SteveintheIoW/T-Display-S3-JK-BMS-BLE-to-Solis-CAN-Pylontech/Photos_Media/All Cell Volts.jpg

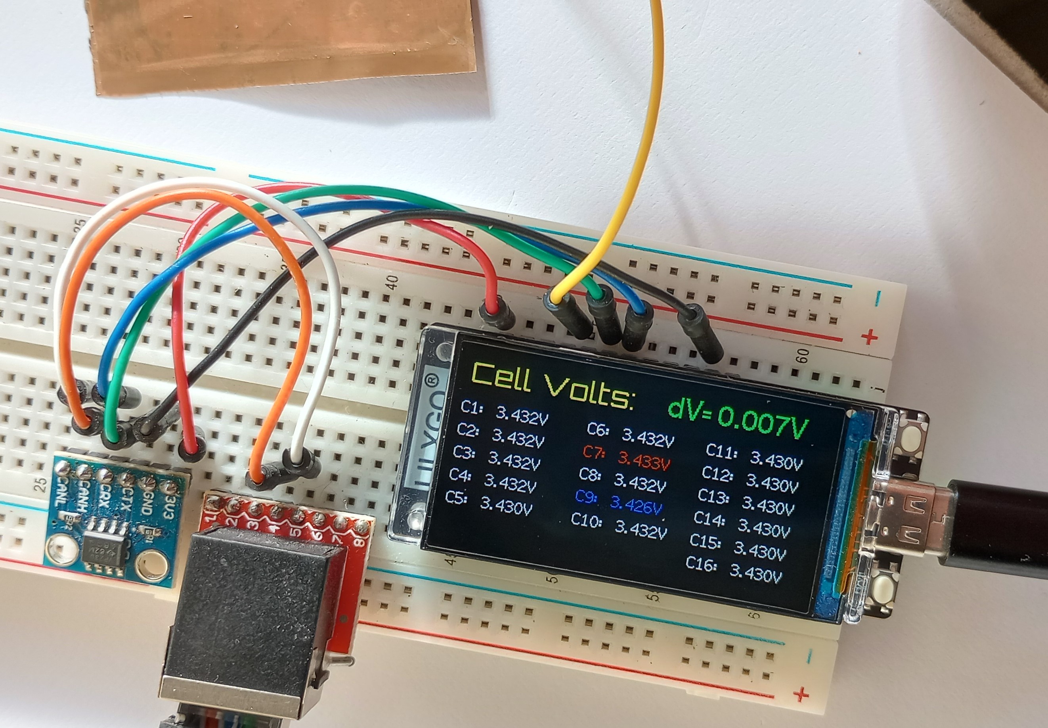
Photos_Media/All Cell Volts.jpg
