SteveintheIoW/T-Display-S3-JK-BMS-BLE-to-Solis-CAN-Pylontech/Photos_Media/CAN Screen.jpg

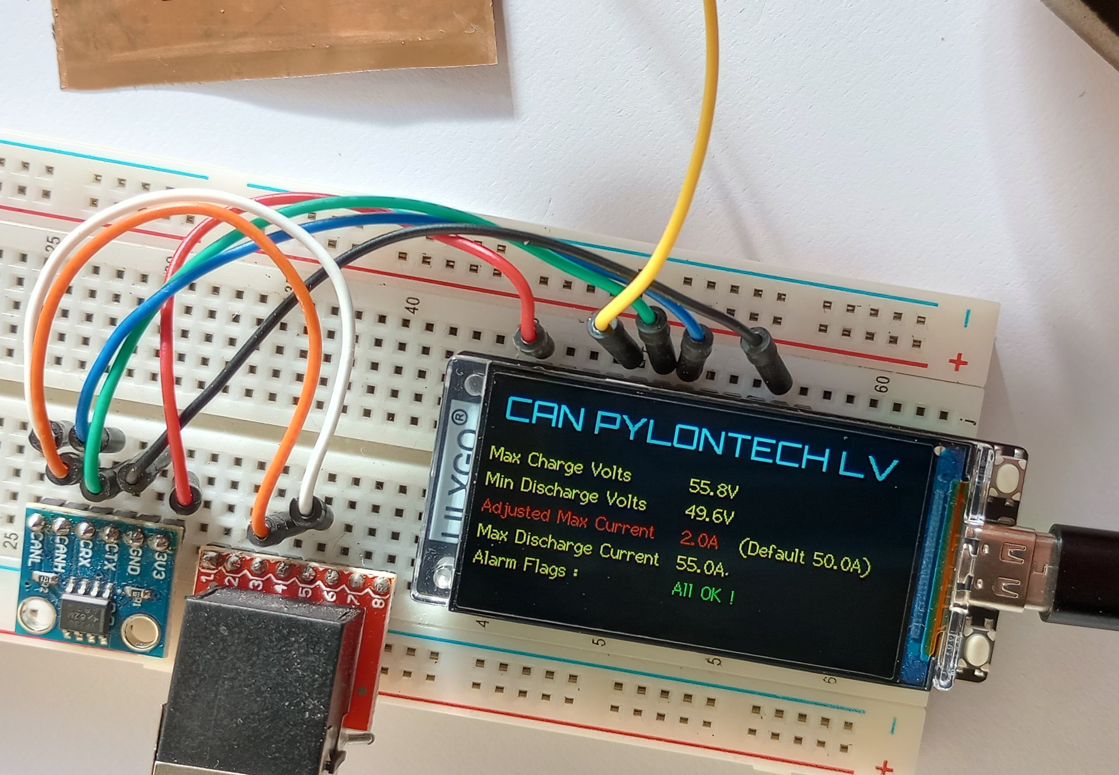
Photos_Media/CAN Screen.jpg
