SteveintheIoW/T-Display-S3-JK-BMS-BLE-to-Solis-CAN-Pylontech/Photos_Media/Copper plant label.jpg

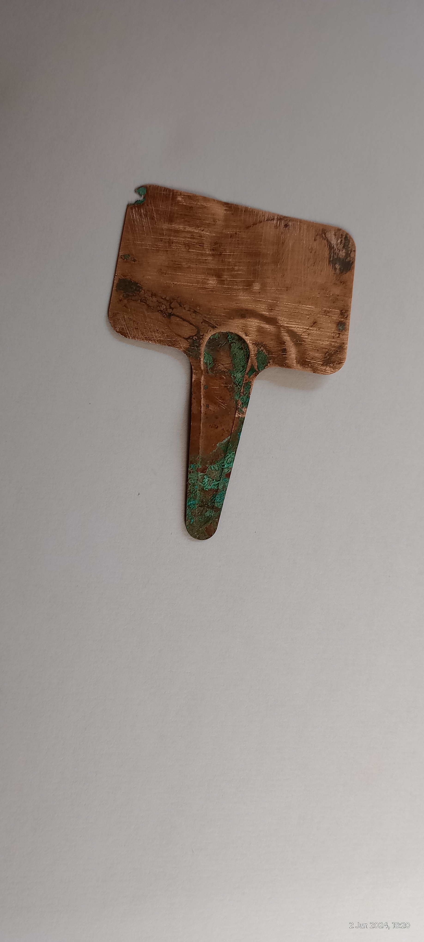
Photos_Media/Copper plant label.jpg
