SteveintheIoW/T-Display-S3-JK-BMS-BLE-to-Solis-CAN-Pylontech/Photos_Media/Found BMS.jpg

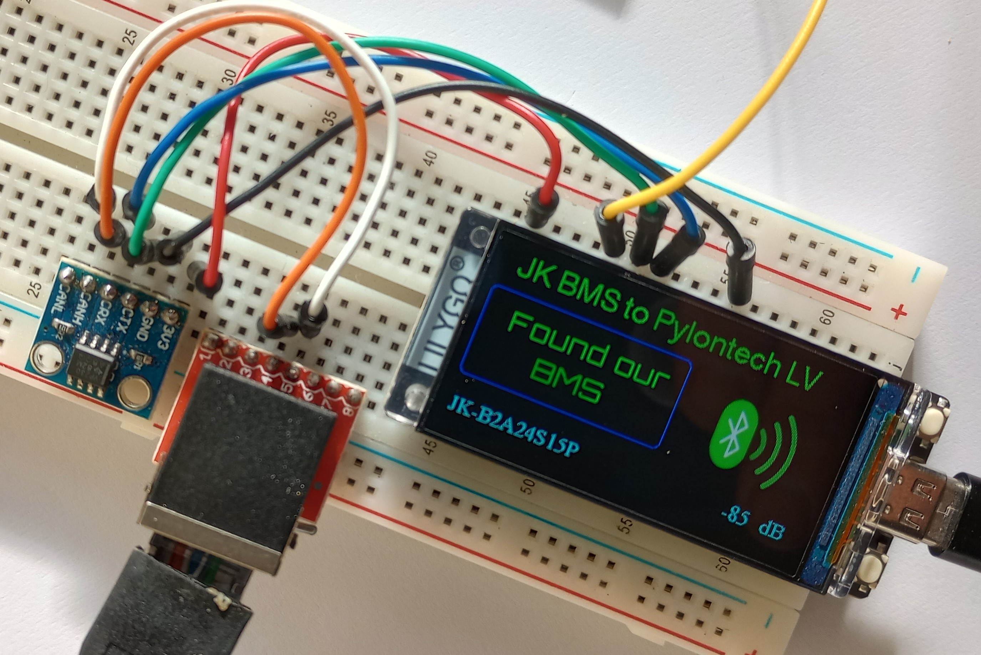
Photos_Media/Found BMS.jpg
