SteveintheIoW/T-Display-S3-JK-BMS-BLE-to-Solis-CAN-Pylontech/Photos_Media/IMG_20240602_184514970_HDR.jpg

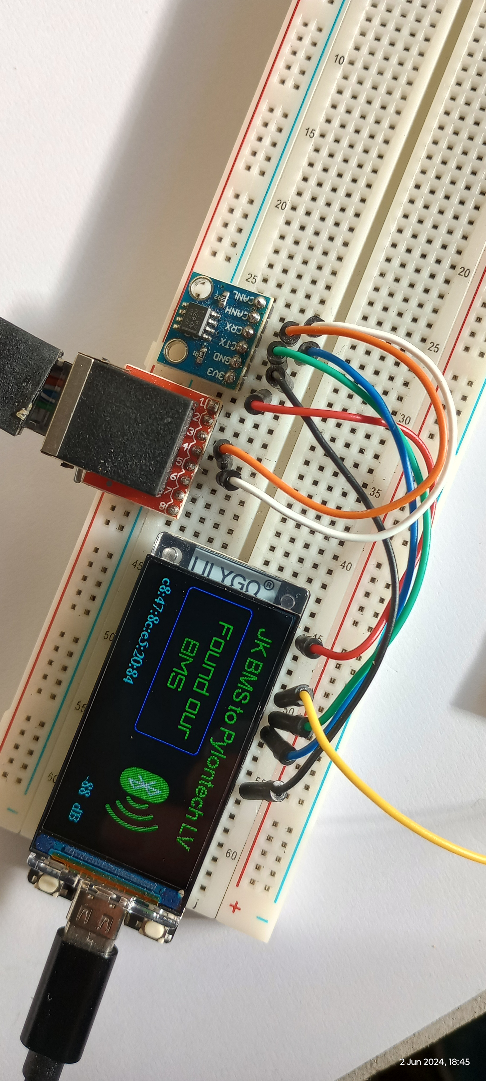
Photos_Media/IMG_20240602_184514970_HDR.jpg
