SteveintheIoW/T-Display-S3-JK-BMS-BLE-to-Solis-CAN-Pylontech/Photos_Media/Interface and Solis EH1 System.jpg

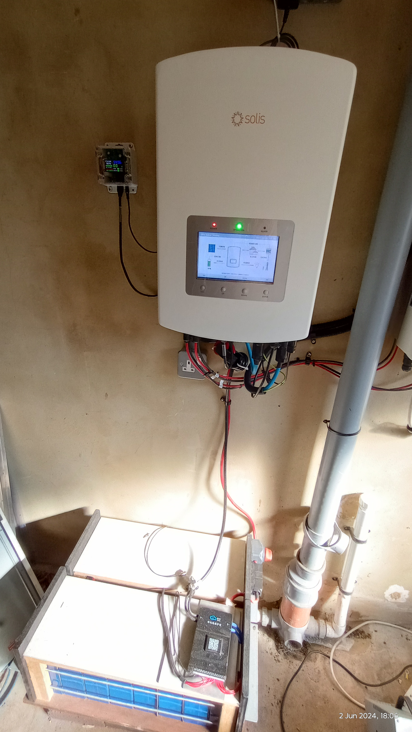
Photos_Media/Interface and Solis EH1 System.jpg
