SteveintheIoW/T-Display-S3-JK-BMS-BLE-to-Solis-CAN-Pylontech/Photos_Media/Multicomp Enclosure.jpg

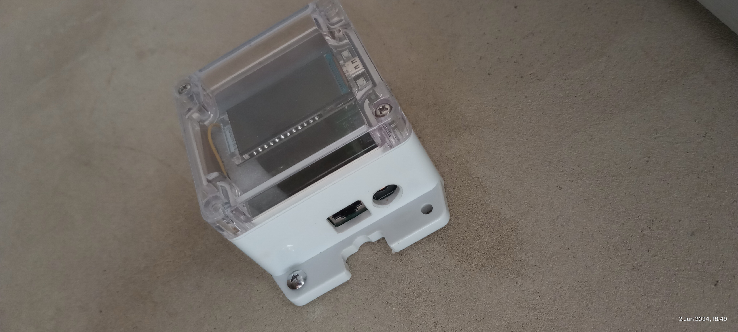
Photos_Media/Multicomp Enclosure.jpg
