SteveintheIoW/T-Display-S3-JK-BMS-BLE-to-Solis-CAN-Pylontech/Photos_Media/PCB in Enclosure.jpg

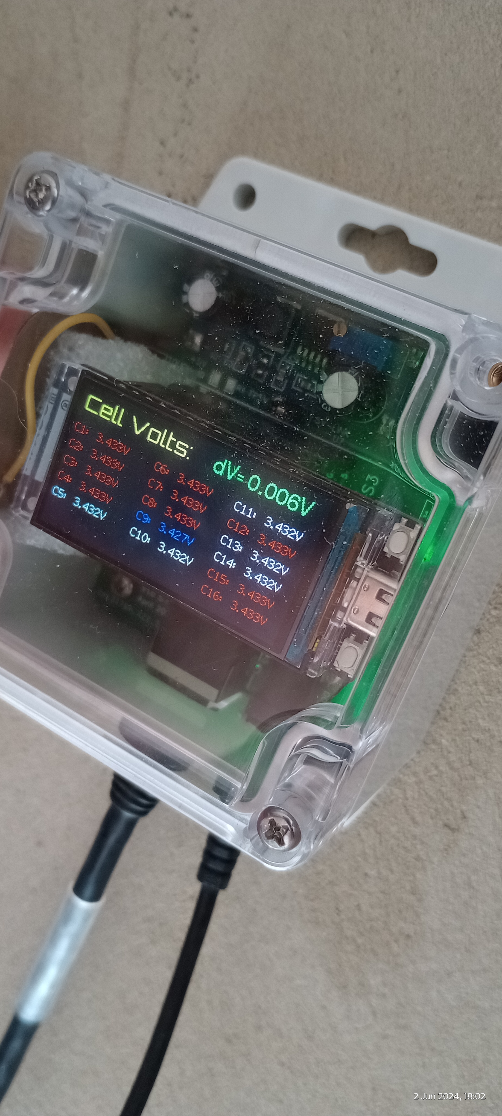
Photos_Media/PCB in Enclosure.jpg
