SteveintheIoW/T-Display-S3-JK-BMS-BLE-to-Solis-CAN-Pylontech/Photos_Media/PCB.jpg

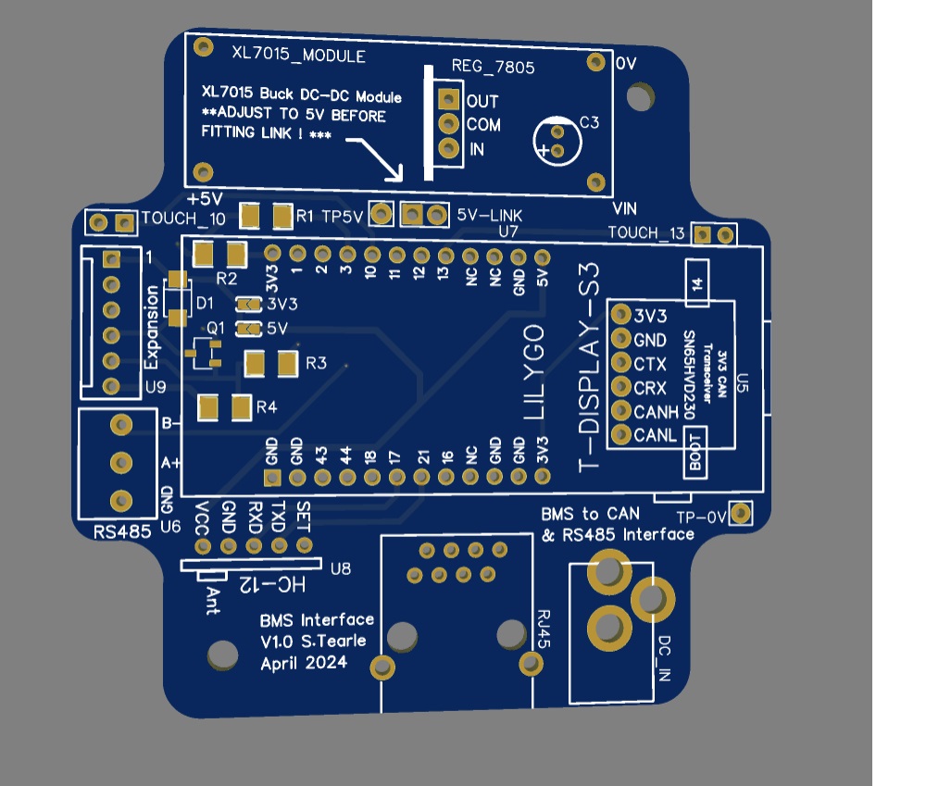
Photos_Media/PCB.jpg
