SteveintheIoW/T-Display-S3-JK-BMS-BLE-to-Solis-CAN-Pylontech/Photos_Media/Touch Pad.jpg

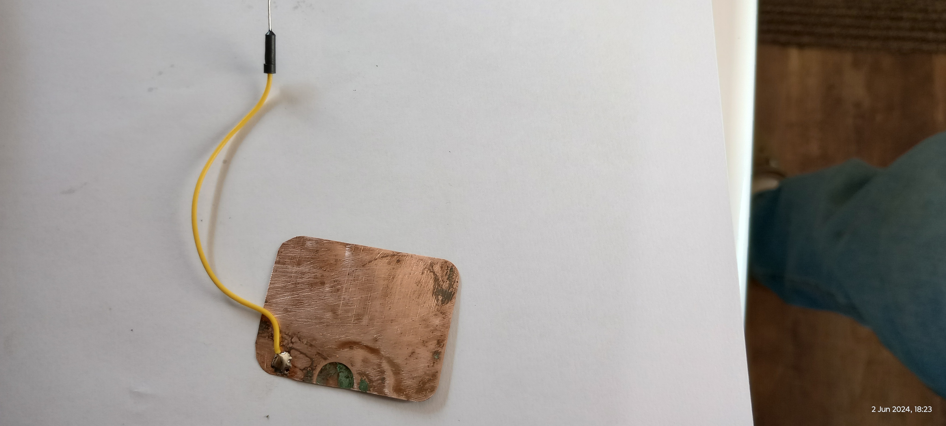
Photos_Media/Touch Pad.jpg
