SteveintheIoW/T-Display-S3-JK-BMS-BLE-to-Solis-CAN-Pylontech/Photos_Media/T-Display S3  JKBMS BLE to CAN Interface  - relevant parts.pdf

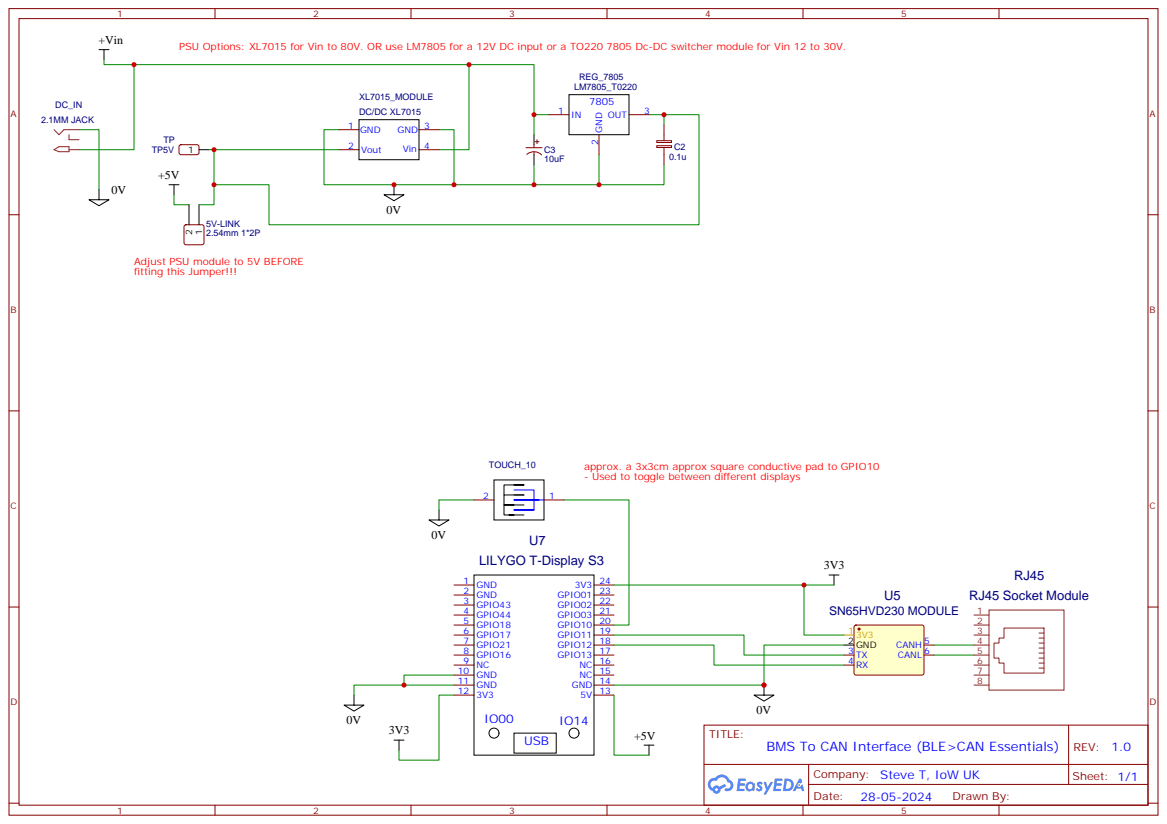
[picture p19: page 1]

PSU Options: XL7015 for Vin to 80V. OR use LM7805 for a 12V DC input or a TO220 7805 Dc-DC switcher module for Vin 12 to 30V. +Vin

Adjust PSU module to 5V BEFORE
fitting this Jumper!!!

approx. a 3x3cm approx square conductive pad to GPIO10
- Used to toggle between different displays

Company: Steve T, IoW UK
