SteveintheIoW/T-Display-S3-JK-BMS-BLE-to-Solis-CAN-Pylontech/Photos_Media/T-Display S3  JKBMS BLE to CAN Interface  - Full PCB cct Diag.pdf

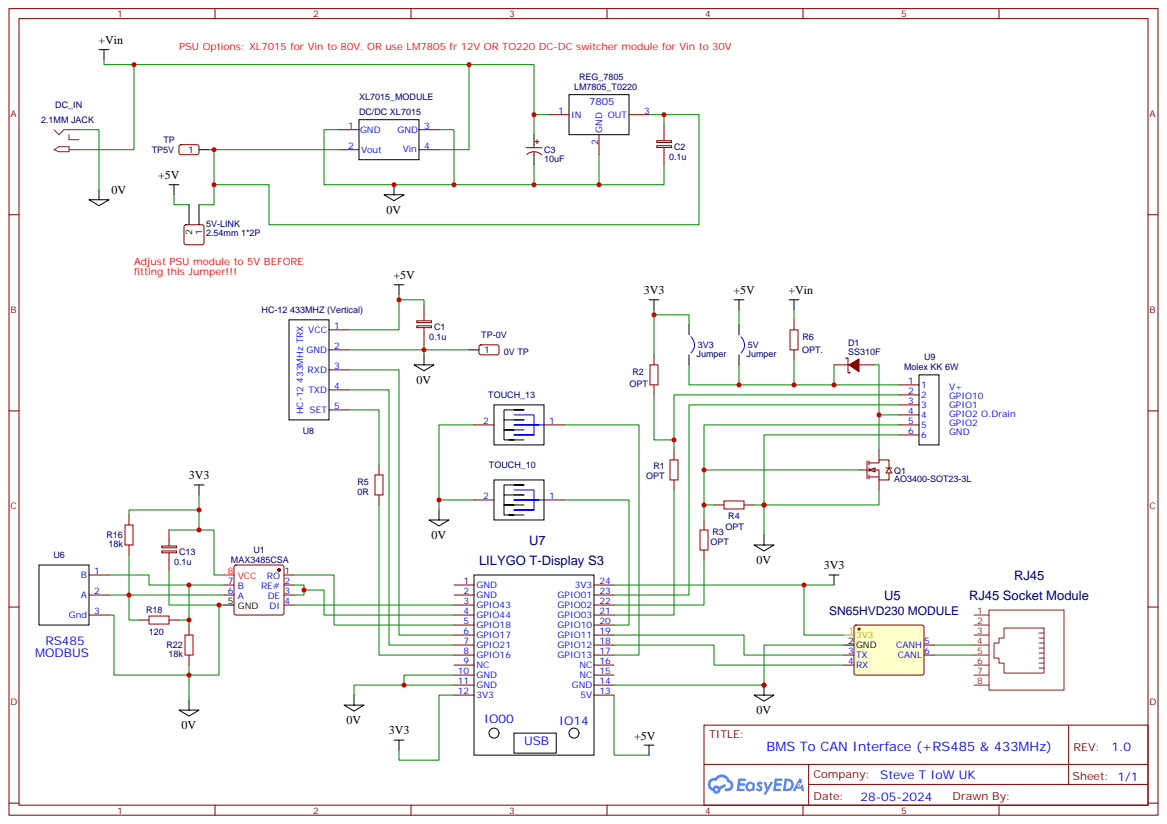
[picture p20: page 1]

PSU Options: XL7015 for Vin to 80V. OR use LM7805 fr 12V OR TO220 DC-DC switcher module for Vin to 30V

Adjust PSU module to 5V BEFORE
fitting this Jumper!!!

Company: Steve T IoW UK
