SteveintheIoW/T-Display-S3-JK-BMS-BLE-to-Solis-CAN-Pylontech/(commit log)

2025-10-21 Add files via upload
    V6a WP adds some changes to correct for small problems with newer ESP32 board compiler files - LEDC deprication & Arduino String handling within BLE code. Also updated code to better manage CAN information and charging control in High and low SOC states (i.e CAN_Charge_Current_Adjust() and CAN_Low_Charge_SOC_Control() routines)
    [BLE_BMS_Connection.ino, BLE_Parse_Data.ino, Display_Screens.ino, JKBMS_BLE_Pylontec_Release_R6a_wip.ino]
2025-11-25 Add files via upload
    #include "BLEUUID.h" added to ensure the Arduino IDE uses BLEDevice.h from the ESP32 board manager library and NOT from the ArduinoBLE library folder
